Deshan-Lokuge01/Filter-Designing/Filter_Design_Report.pdf

DEPARTMENT OF ELECTRICAL AND INFORMATION ENGINEERING

## FACULTY OF ENGINEERING UNIVERSITY OF RUHUNA

## EE5207: ELECTRONIC CIRCUIT DESIGN

Project Report

Designing a 9th Order Chebyshev Low Pass Filter with a 9 kHz cut–off frequency

### GROUP NO. 07

PREFACE

Filters are used in modern electronic systems to control the frequency of signals. Chebyshev filters

are preferred because they can provide sharp frequency transitions with a limited ripple in the

passband.

This project aims at designing a 9th-order Chebyshev low-pass filter with a cut-off

frequency of 9 kHz and a passband ripple of 3 dB. The purpose is to put theoretical ideas of filter

design into practice through simulation of filter performance.

Throughout this project, we obtained practical expertise with filter design and signal

processing applications. We believe this study is beneficial to people interested in filter design and

related fields.

TABLE OF CONTENTS

10

LIST OF FIGURES

### 1 INTRODUCTION

The development of efficient and accurate filters is a key part of modern signal processing

and electronic systems. Among many filter types, the Chebyshev filter is distinguished by its ability

to create a quick roll-off at the cut-off frequency while maintaining controlled ripples throughout

the passband, making it excellent for applications needing high selectivity and low distortion.

This project focuses on developing a 9th-order Chebyshev low-pass filter with a 9 kHz cut-

off frequency and a 3 dB passband ripple. The 9th-order design enables a very precise

and steep transition from the | passband to the stopband, thus meeting the | strict
requirements for filtering low-frequency signals. A specification of 3 | dB | passband
ripple achieves an equilibrium between | flatness | and general performance of the

filter, which enhances its applicability in real-world scenarios.

The key objectives of this project are to derive the mathematical parameters for the filter

design, simulate the circuit to evaluate its behavior, and validate its performance against theoretical

expectations. The results of the project find useful applications in several industry sectors,

specifically telecommunications, audio engineering, and instrumentation, where high-performance

filtering solutions are a must.

Through this project, | we | hope | to gain a better understanding | of advanced | filter

design, hone our skills in the analysis and implementation of circuits, and contribute something

useful to the development of accurate signal processing solutions.

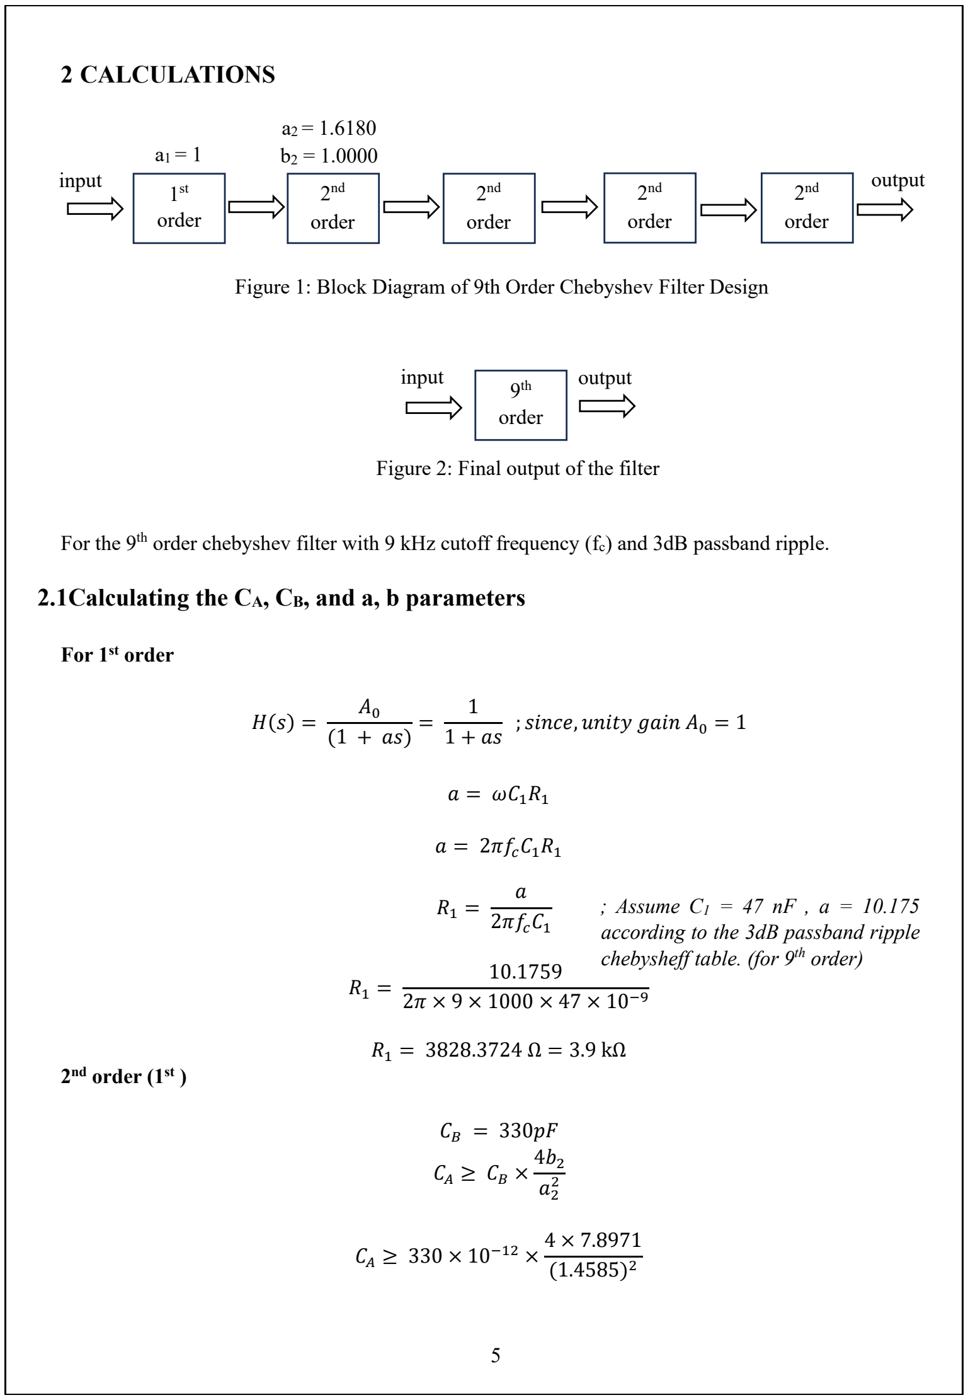
[picture p6: figure]
; Assume C1 = 47 nF , a = 10.175 according to the 3dB passband ripple chebysheff table. (for 9th order); 2 CALCULATIONS; For 1; st order; ; since, unity gain A0 = 1; a = 2πfcC1R1; a 2πfcC1; nd order (1st ); order; input; output; Figure 2: Final output of the filter

For the 9th order chebyshev filter with 9 kHz cutoff frequency (fc) and 3dB passband ripple.

2.1Calculating the CA, CB, and a, b parameters

Figure 1: Block Diagram of 9th Order Chebyshev Filter Design

CA ≥ 4.9 nF

CA = 10 nF
CB = 330 pF
a2 = 1.4585
b2 = 7.8971

2

nd order (2nd )

CB = 330pF

CA ≥ CB ×

4b3
a3

2

CA ≥ 330 × 10⁻¹² ×

4 × 2.3651
(0.3561)

2

CA ≥ 24.62 nF

CA = 27 nF
CB = 330 pF
a3 = 0.3561
b3 = 2.3651

2

nd order (3rd )

CB = 330pF

CA ≥ CB ×

4b4
a4

2

CA ≥ 330 × 10⁻¹² ×

4 × 1.3165
(0.1294)

2

CA ≥ 103.78 μF

CA = 120 nF
CB = 330 pF
a4 = 0.1294
b4 = 1.3165

2

nd order (4th )

CB = 330pF

CA ≥ CB ×

4b5
a5

2

CA ≥ 330 × 10⁻¹² ×

4 × 1.0210
(0.0348)

2

CA ≥ 1.113 μF

CA = 1.5 μF
CB = 330 pF
a5 = 0.0348
b5 = 1.0210

### 2.2 Calculating the resistor values and capacitor values

For 1

st order

2

nd order (1st )

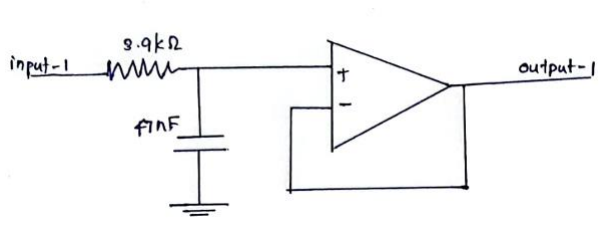
[picture p7: figure]
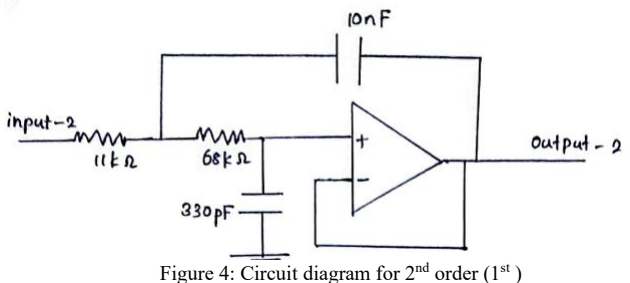
[picture p8: figure]

RA,B =

a2CA ± √a2
2CA

2 − 4b2CACB
4πfcCACB

Figure 3 : Circuit diagram for first order

Figure 4: Circuit diagram for 2nd order (1st )

RA,B =

1.4585 ± √1.4585² × (10 × 10⁻⁹) 2 − 4 × 7.8971 × 10 × 10⁻⁹ × 330 × 10⁻¹² 4π × 9000 × 10 × 10⁻⁹ × 330 × 10⁻¹²

RA,B = 66985.4687 Ω, 11171.933Ω

RA = 11 kΩ
RB = 68 kΩ
CA = 10 nF
CB = 330 pF

2

nd order (2nd
)

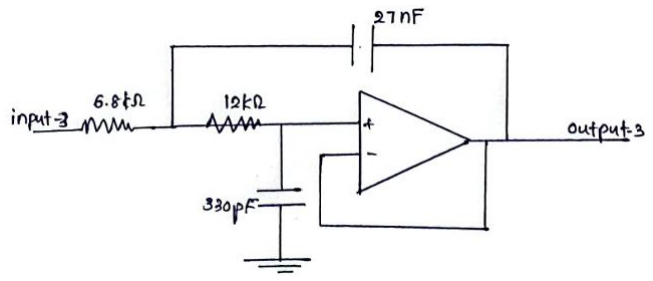
[picture p9: figure]

RA,B =

a3CA ± √a3
2CA

2 − 4b3CACB
4πfcCACB
`

RA,B =

0.3561 × 27 × 10⁻⁹ ± √0.3561² × (27 × 10⁻⁹) 2 − 4 × 2.3651 × 27 × 10⁻⁹ × 330 × 10⁻¹² 4π × 9000 × 27 × 10⁻⁹ × 330 × 10⁻¹²

RA = 6708.1937 Ω = 6.8 kΩ
RB = 12374.3233 Ω = 12 kΩ
CA = 27 nF
CB = 330 pF

2

nd order (3

rd )

Figure 5 : Circuit diagram for 2nd order (2nd )

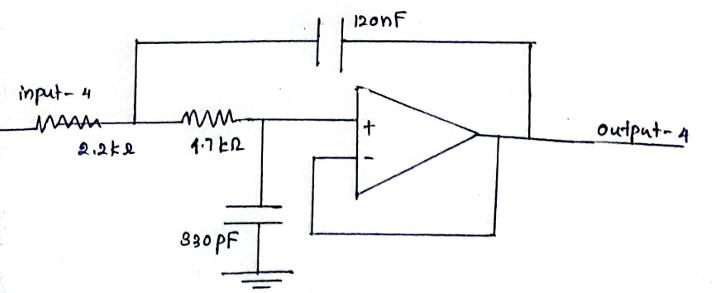
[picture p10: figure]

Figure 6 : Circuit diagram for 2nd order (3rd )

RA,B =

a4CA ± √a4
2CA

2 − 4b4CACB
4πfcCACB
`

RA,B =

0.1294 × 120 × 10⁻⁹ ± √(0.1294 × 120 × 10⁻⁹) 2 − 4 × 1.3165 × 120 × 10⁻⁹ × 330 × 10⁻¹² 4π × 9000 × 120 × 10⁻⁹ × 330 × 10⁻¹²

RA = 4741.68 Ω = 4.7 kΩ
RB = 2192.546 Ω = 2.2 kΩ
CA = 120 nF
CB = 330 pF

2

nd order (4

th )

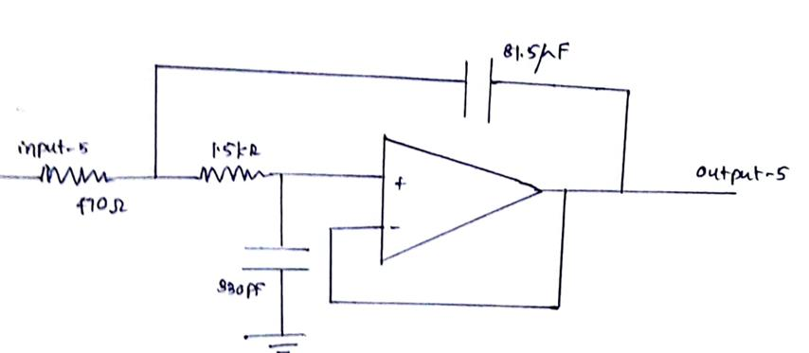
[picture p11: figure]

RA,B =

a5CA ± √a5
2CA

2 − 4b5CACB
4πfcCACB
`

RA,B =

0.0348 × 1.5 × 10⁻⁶ ± √(0.0348 × 1.5 × 10⁻⁶) 2 − 4 × 1.021 × 1.5 × 10⁻⁶ × 330 × 10⁻¹² 4π × 9000 × 1.5 × 10⁻⁶ × 330 × 10⁻¹²

RA = 1406.12 Ω = 1.5 kΩ
RB = 458.726 Ω = 470 kΩ
CA = 1.5 μF
CB = 330 pF

Figure 7 :Circuit diagram for 2nd order (4th )

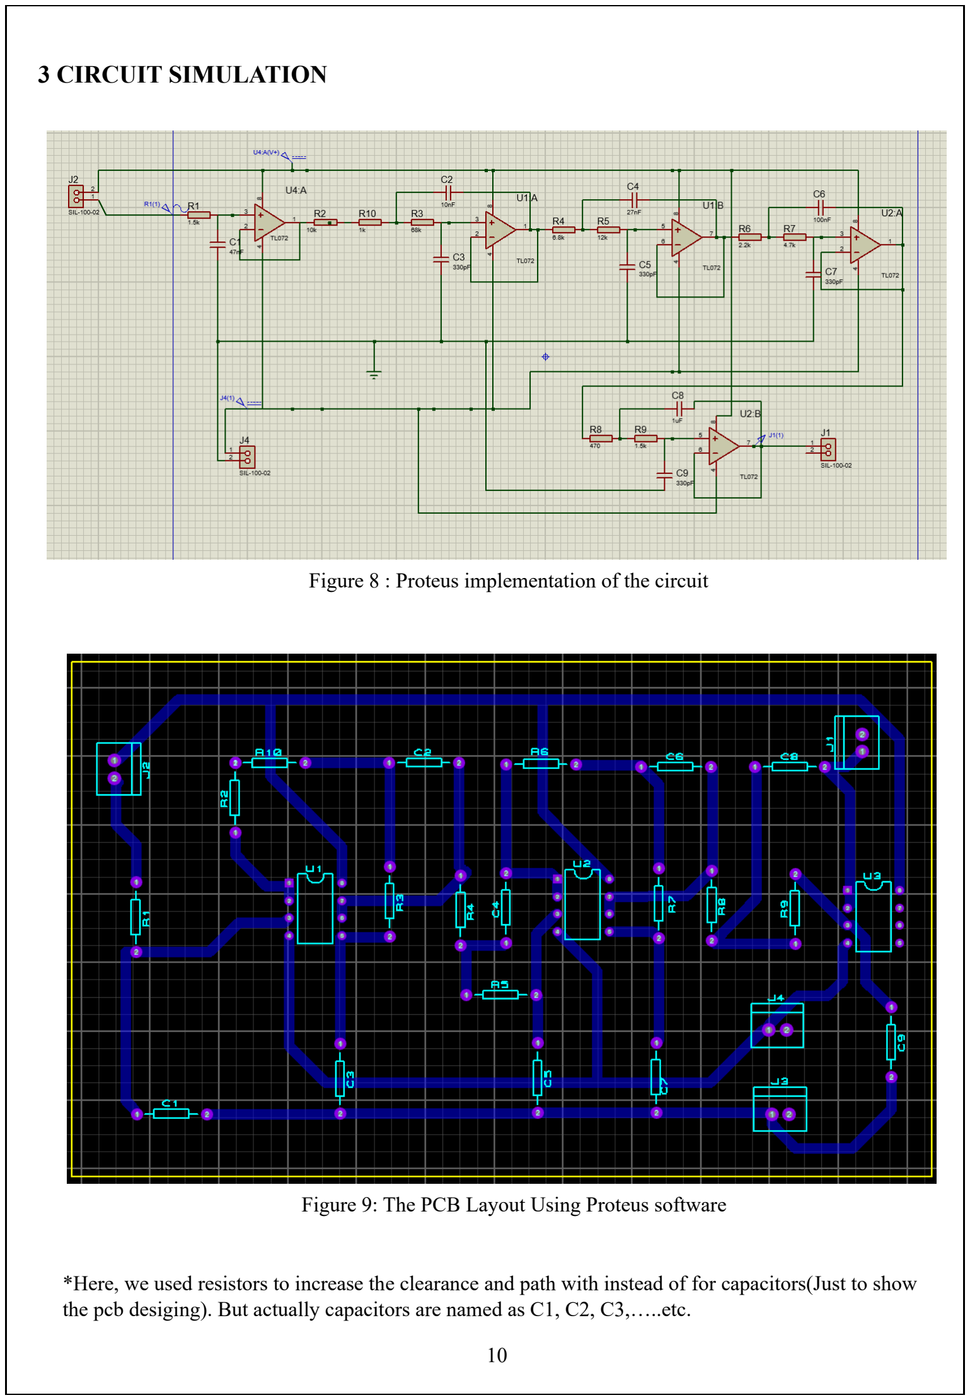
[picture p12: page 11]

### 3 CIRCUIT SIMULATION

*Here, we used resistors to increase the clearance and path with instead of for capacitors(Just to show the pcb desiging). But actually capacitors are named as C1, C2, C3,…..etc.

Figure 8 : Proteus implementation of the circuit

Figure 9: The PCB Layout Using Proteus software

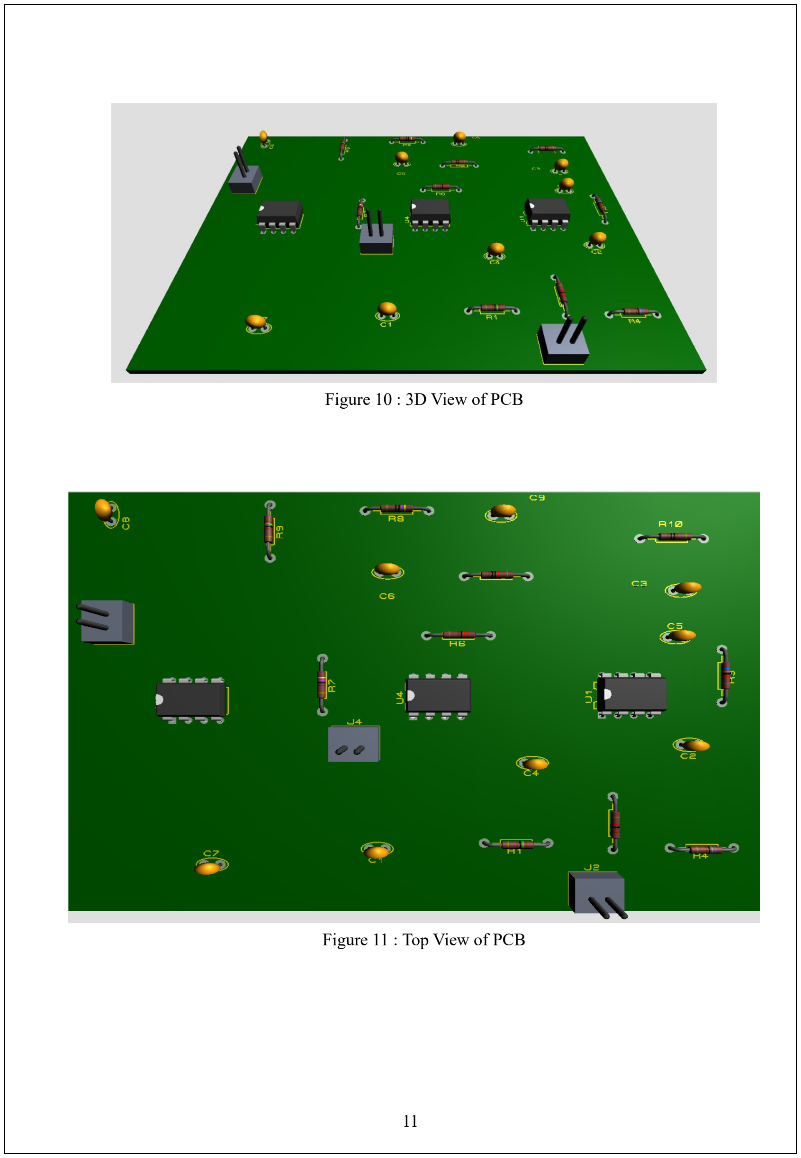
[picture p13: page 12]

Figure 10 : 3D View of PCB

Figure 11 : Top View of PCB

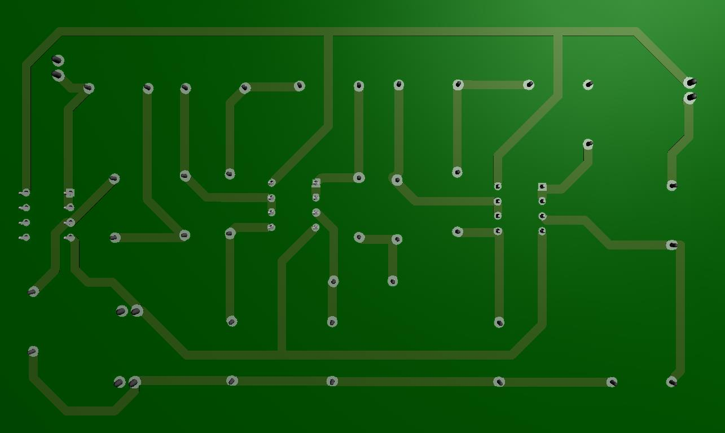
[picture p14: figure]

Figure 12: Bottom View of PCB

### 4 PRACTICAL IMPLEMENTATIONS

PCB Manufacturing Process

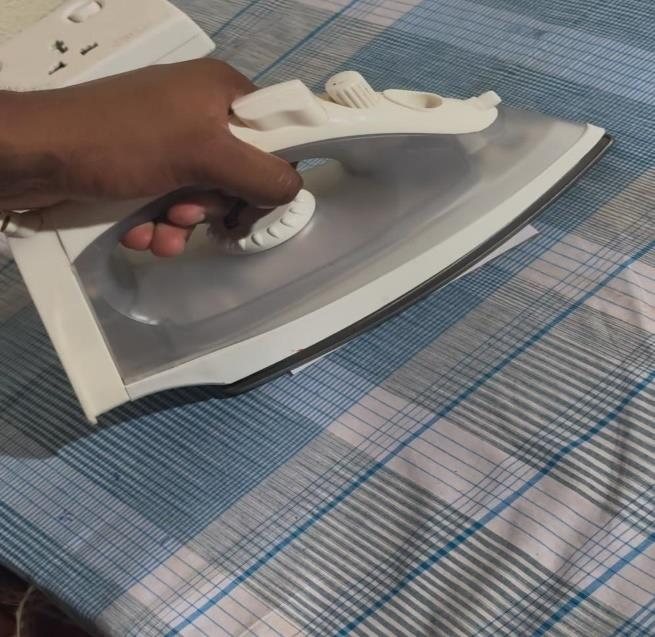
[picture p15: figure]

Figure 13: Image Transferring to the copper board

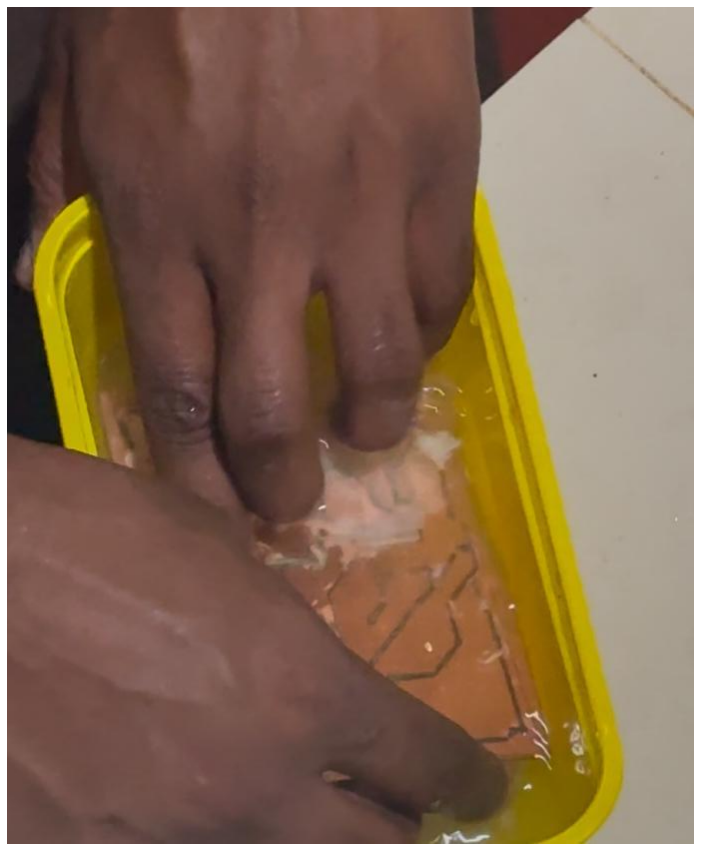
[picture p16: figure]

Figure 14: Etching Process

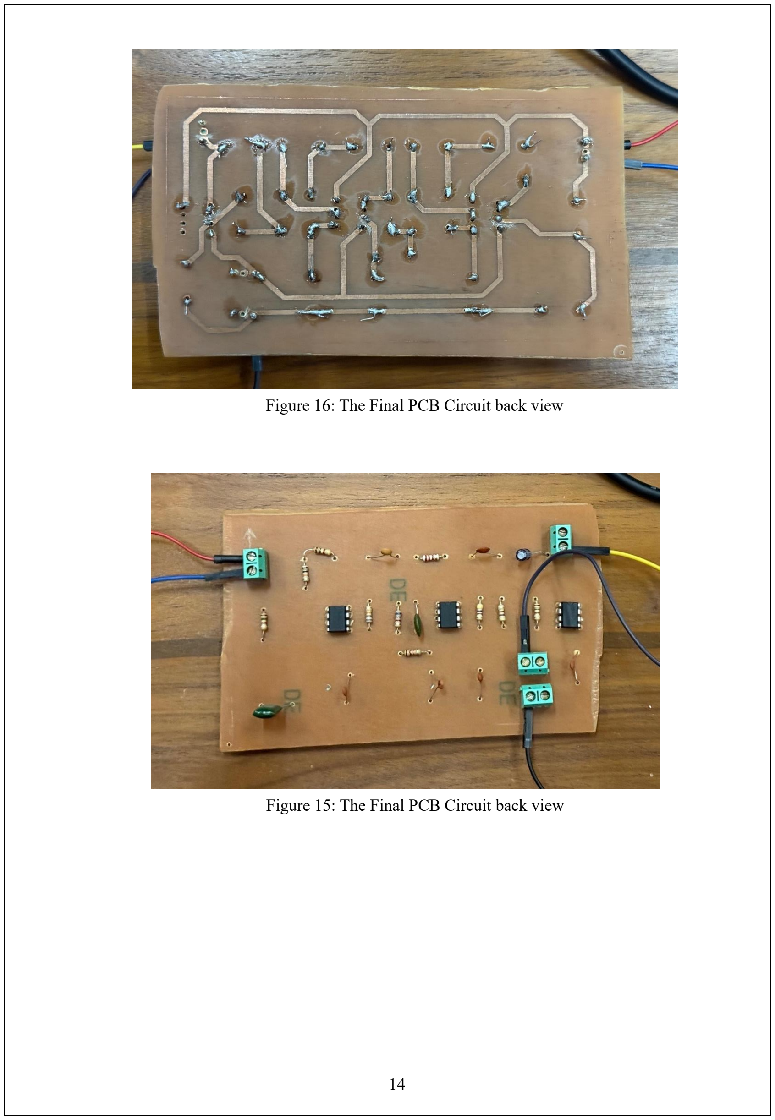
[picture p17: page 15]

Figure 16: The Final PCB Circuit back view

Figure 15: The Final PCB Circuit back view

### 5 RESULTS

- Simulations Results

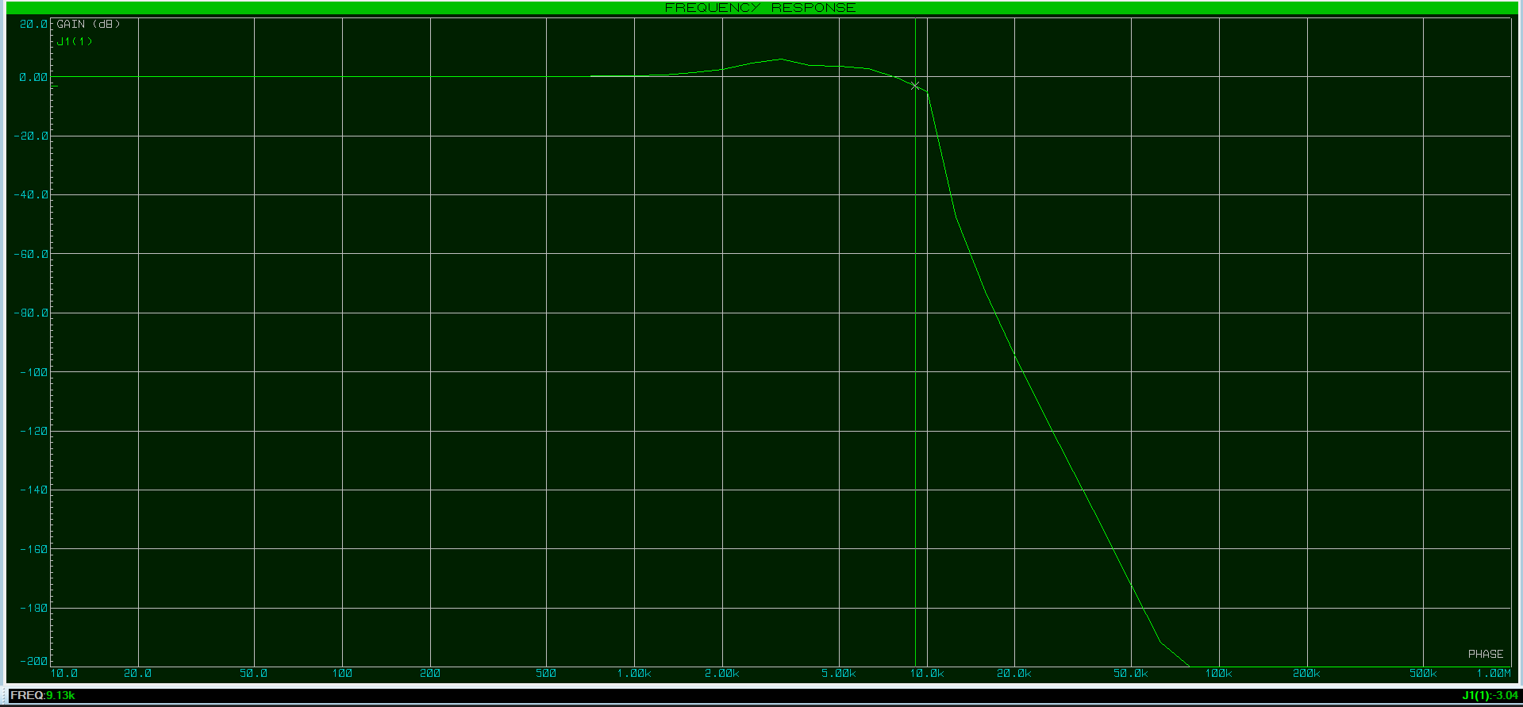
[picture p18: figure]

At the cursor point frequency is 9.13 kHz

Gain in the y axis is -3.04 dB

(Sine wave generator , Vpp = 10V and f = 1 kHz)

+Vcc = 12V and -Vcc = -12V

*These values are taken in adjusting the cursor approximately

Figure 17: Frequency Response of the Circuit

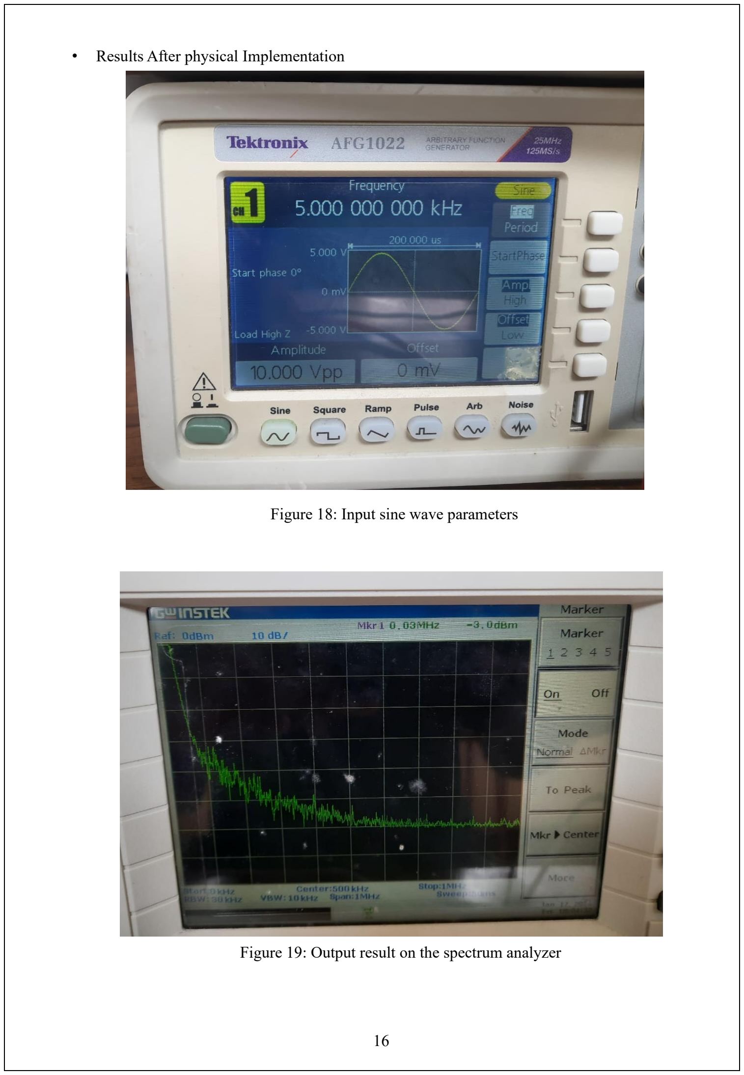
[picture p19: page 17]

- Results After physical Implementation

Figure 18: Input sine wave parameters

Figure 19: Output result on the spectrum analyzer

### 6. DISCUSSION

Even though we plugged the calculated values for the capacitor and the resistor values , we are getting

around 30 kHz bandwidth. It may be the reason because of the clearance between the conducting

path may increase the capacitance value of the line or may be the resistor values and the capacitor

values may differ than that they have mentioned on there.
