Deshan-Lokuge01/Filter-Designing/(list of files, drawings)

Other design files:
Filter_Design_Project.pdsprj
